Manashvi1205/warehouse-rover/code/src/src/bot_scanning/bot_scanning/callibration_images/img14.jpg

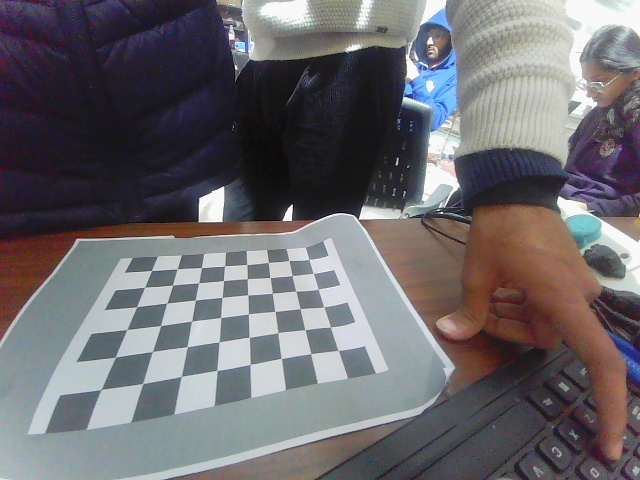
code/src/src/bot_scanning/bot_scanning/callibration_images/img14.jpg
