Manashvi1205/warehouse-rover/docs/assets/hero-qr-scan.jpg

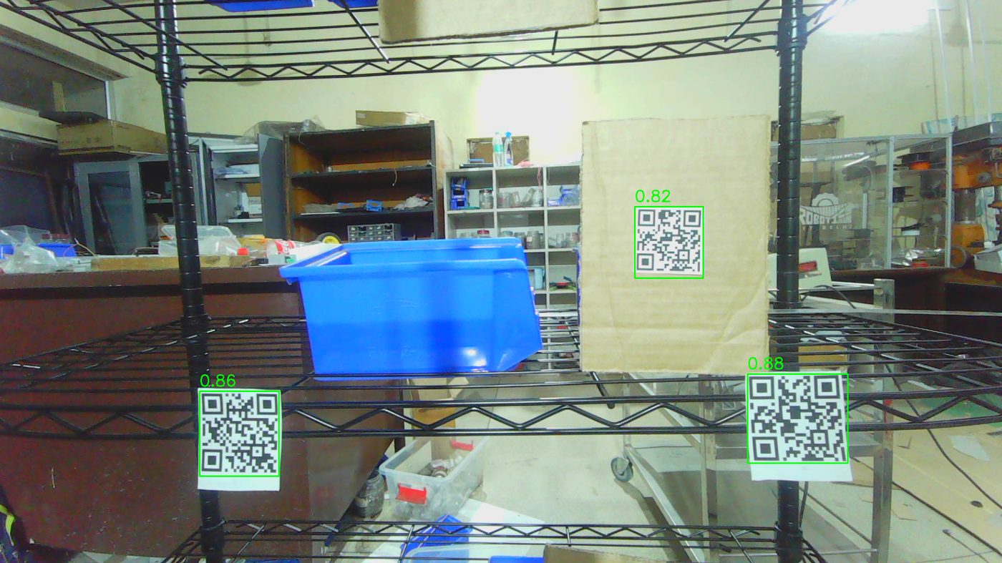
docs/assets/hero-qr-scan.jpg
