Manashvi1205/warehouse-rover/docs/assets/qr-sample.png

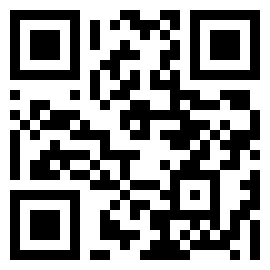
docs/assets/qr-sample.png
