Manashvi1205/warehouse-rover/vision/website/captures/2025-12-03_06-24-13.png

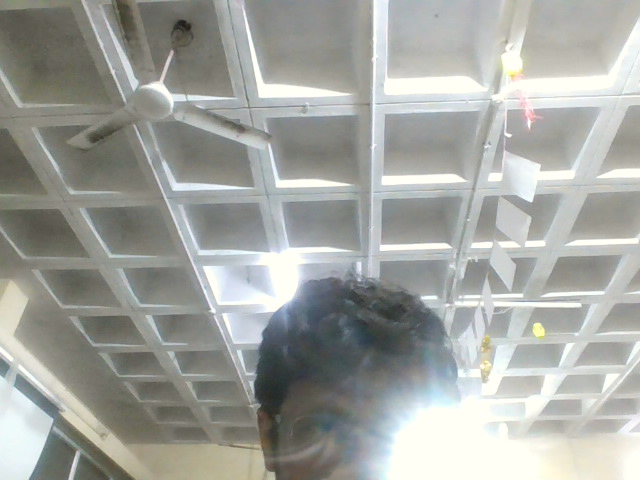
vision/website/captures/2025-12-03_06-24-13.png
