Manashvi1205/warehouse-rover/vision/website/captures/burst_2025-12-03_06-02-02.png

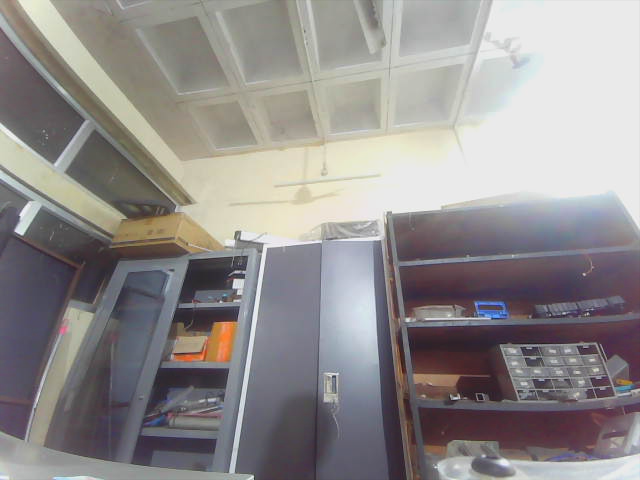
vision/website/captures/burst_2025-12-03_06-02-02.png
