Manashvi1205/warehouse-rover/vision/website/captures/burst_2025-12-03_06-06-05.png

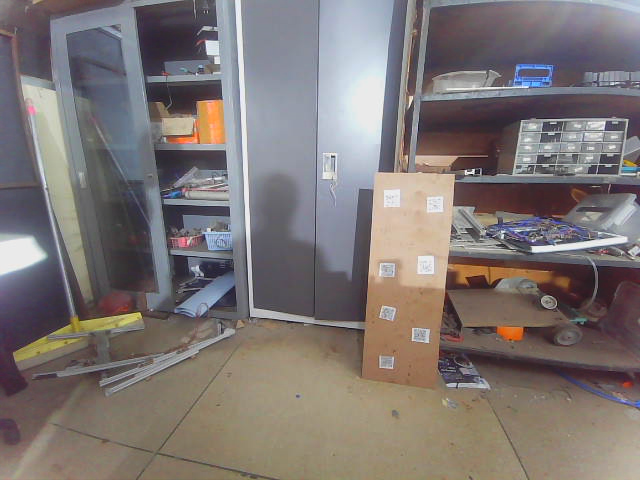
vision/website/captures/burst_2025-12-03_06-06-05.png
