Manashvi1205/warehouse-rover/vision/website/captures/capture_2025-12-03_06-26-14.png

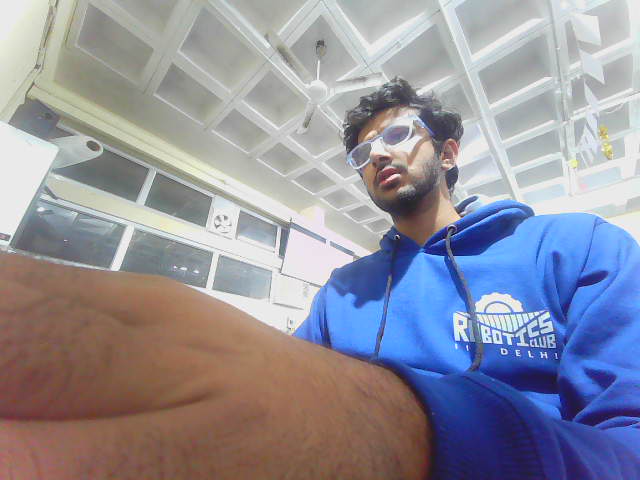
vision/website/captures/capture_2025-12-03_06-26-14.png
