Manashvi1205/warehouse-rover/vision/website/captures/capture_2025-12-03_06-27-51.png

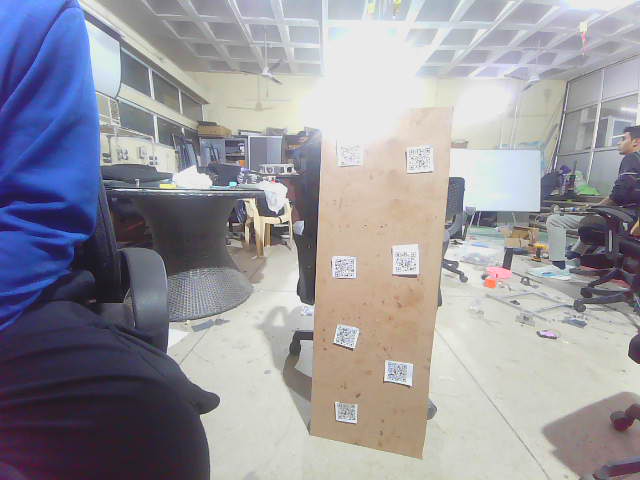
vision/website/captures/capture_2025-12-03_06-27-51.png
