Manashvi1205/warehouse-rover/vision/website/QR_R01_S1_ITM000.png

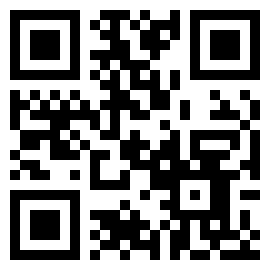
vision/website/QR_R01_S1_ITM000.png
