Manashvi1205/warehouse-rover/vision/website/QR_R01_S2_ITM345.png

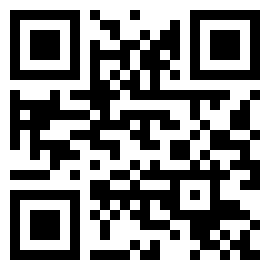
vision/website/QR_R01_S2_ITM345.png
