Manashvi1205/warehouse-rover/vision/website/QR_R01_S3_ITM347.png

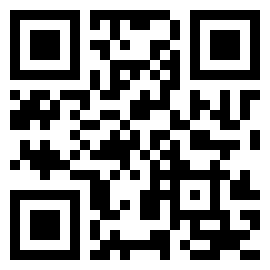
vision/website/QR_R01_S3_ITM347.png
