Manashvi1205/warehouse-rover/vision/website/QR_R01_S4_ITM555.png

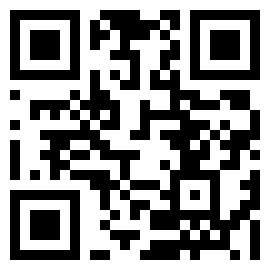
vision/website/QR_R01_S4_ITM555.png
