Manashvi1205/warehouse-rover/vision/website/QR_R01_S4_ITM996.png

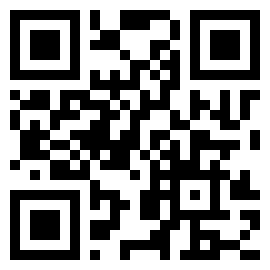
vision/website/QR_R01_S4_ITM996.png
