Manashvi1205/warehouse-rover/vision/website/QR_R01_S5_ITM031.png

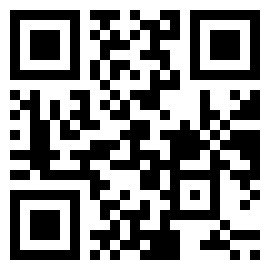
vision/website/QR_R01_S5_ITM031.png
