Manashvi1205/warehouse-rover/vision/website/QR_R02_S1_ITM001.png

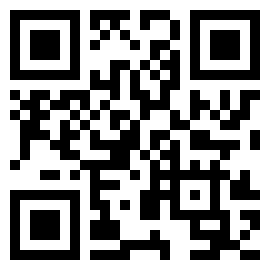
vision/website/QR_R02_S1_ITM001.png
