Manashvi1205/warehouse-rover/vision/website/QR_R02_S2_ITM121.png

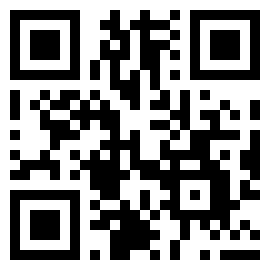
vision/website/QR_R02_S2_ITM121.png
