Manashvi1205/warehouse-rover/vision/website/QR_R02_S3_ITM008.png

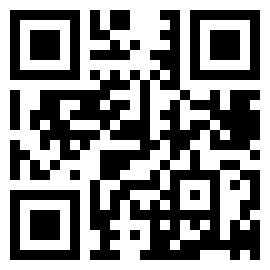
vision/website/QR_R02_S3_ITM008.png
