Manashvi1205/warehouse-rover/vision/website/QR_R02_S4_ITM299.png

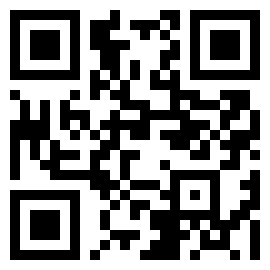
vision/website/QR_R02_S4_ITM299.png
