Manashvi1205/warehouse-rover/vision/website/QR_R02_S7_ITM067.png

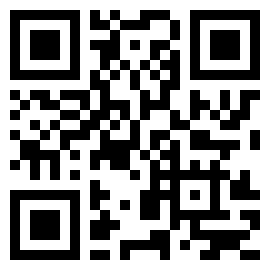
vision/website/QR_R02_S7_ITM067.png
