Manashvi1205/warehouse-rover/vision/website/QR_R03_S2_ITM451.png

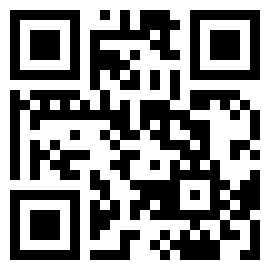
vision/website/QR_R03_S2_ITM451.png
