Manashvi1205/warehouse-rover/vision/website/QR_R04_S5_ITM012.png

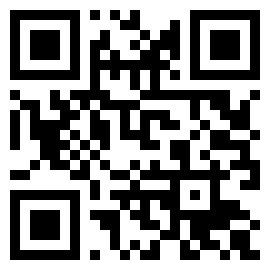
vision/website/QR_R04_S5_ITM012.png
