Manashvi1205/warehouse-rover/code/src/src/bot_description/urdf/meshes/base_link.stl

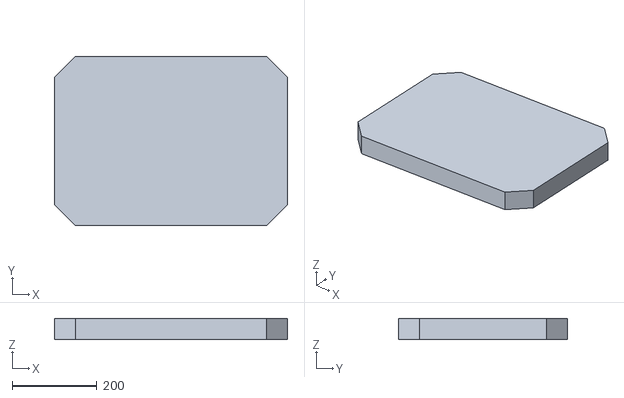
[picture p67: CAD file, 2026-11-06]
code/src/src/bot_description/urdf/meshes/base_link.stl
550.0 x 400.0 x 50.0
