Manashvi1205/warehouse-rover/code/src/src/bot_description/urdf/meshes/upper_box.stl

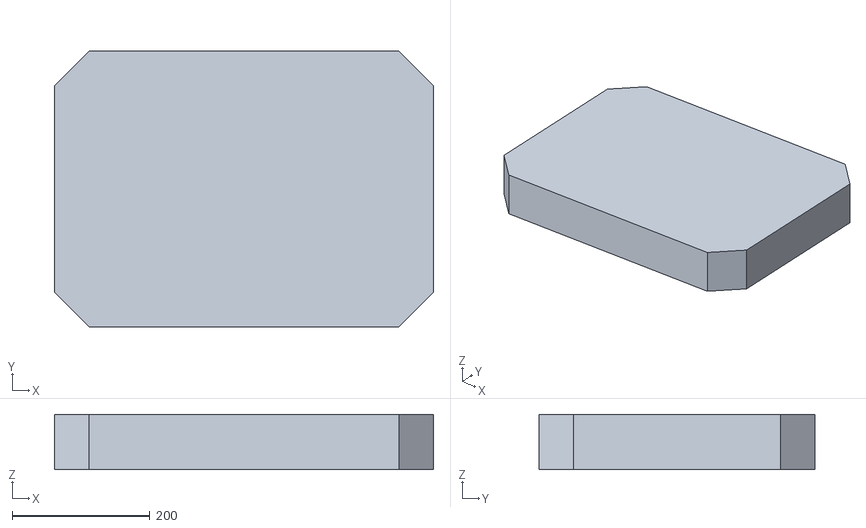
[picture p68: CAD file, 2026-11-06]
code/src/src/bot_description/urdf/meshes/upper_box.stl
550.0 x 400.0 x 80.0
