Manashvi1205/warehouse-rover/code/src/src/bot_description/urdf/meshes/pillars.stl

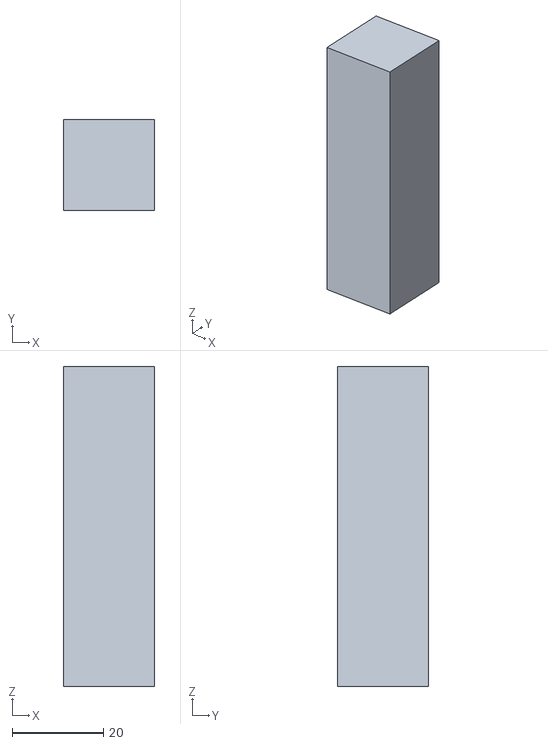
[picture p69: CAD file, 2026-11-06]
code/src/src/bot_description/urdf/meshes/pillars.stl
20.0 x 20.0 x 70.0
