Manashvi1205/warehouse-rover/code/src/src/bot_description/urdf/meshes/sphere.stl

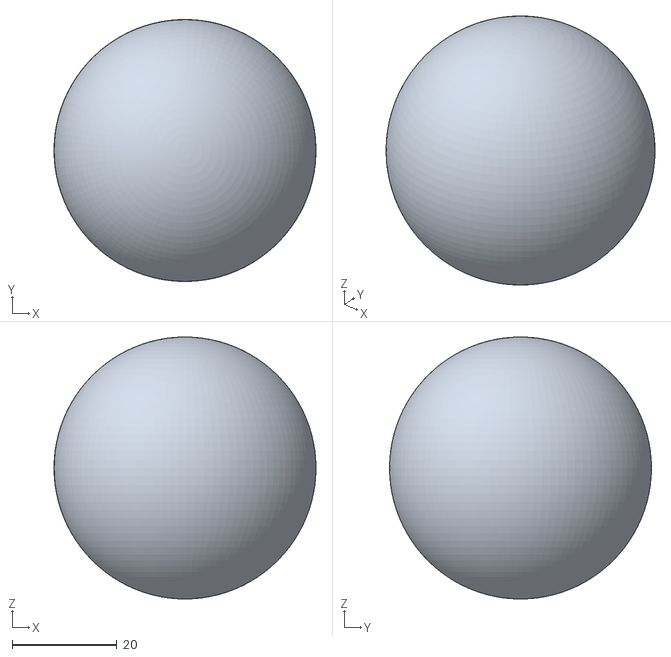
[picture p70: CAD file, 2026-11-06]
code/src/src/bot_description/urdf/meshes/sphere.stl
50.0 x 50.0 x 50.0
