Manashvi1205/warehouse-rover/code/src/src/bot_description/urdf/meshes/wheel.stl

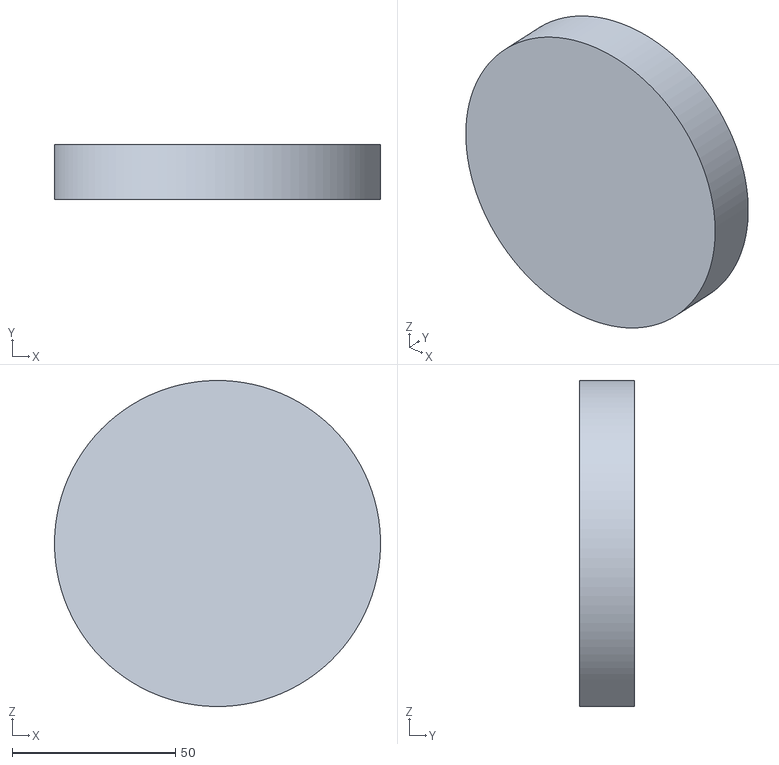
[picture p71: CAD file, 2026-11-06]
code/src/src/bot_description/urdf/meshes/wheel.stl
100.0 x 17.0 x 100.0
