Manashvi1205/warehouse-rover/(list of files, cad)

Other CAD files:
code/src/src/bot_description/worlds/meshes/full_arena.stl
hardware/CAD_Models/CAD and Drawings/Bot.step
