Manashvi1205/warehouse-rover/code/src/src/bot_description/urdf/mobile_robot.xacro

<?xml version="1.0"?>
<robot xmlns:xacro="http://www.ros.org/wiki/xacro">
  <xacro:property name="base_length" value="0.55" />
  <xacro:property name="base_width" value="0.4" />
  <xacro:property name="base_height" value="0.06" />
  <xacro:property name="wheel_radius" value="0.05" />
  <xacro:property name="wheel_length" value="0.02" />
  <xacro:macro name="wheel_link" params="prefix">
    <link name="${prefix}_wheel_link">
       <visual>
        <geometry>
          <cylinder radius="${wheel_radius}" length="${wheel_length}" />
        </geometry>
        <origin xyz="0 0 0" rpy="${pi / 2.0} 0 0" /><material name="gray" />
      </visual>
      <collision>
        <geometry>
          <sphere radius="${wheel_radius}"/>
        </geometry>
        <origin xyz="0 0 0" rpy="0 0 0" /><material name="gray" />
      </collision>
      <xacro:cylinder_inertia m="1.0" r="${wheel_radius}" l="${wheel_length}" o_xyz="0 0 0" o_rpy="${pi / 2.0} 0 0" />
    </link>
  </xacro:macro>
  <link name="base_link">
    <visual>
      <geometry>
        <box size="${base_length} ${base_width} ${base_height}" />
      </geometry>
      <origin xyz="0 0 ${base_height / 2.0}" rpy="0 0 0" />
      <material name="green" />
    </visual>
    <collision>
      <geometry>
        <box size="${base_length} ${base_width} ${base_height}" />
      </geometry>
      <origin xyz="0 0 ${base_height / 2.0}" rpy="0 0 0" />
    </collision>
    <xacro:box_inertia m="5.0" x="${base_length}" y="${base_width}" z="${base_height}" o_xyz="0 0 ${base_height / 2.0}" o_rpy="0 0 0" /> 
  </link>
  <xacro:wheel_link prefix="right" />
  <!-- <link name="right_wheel_link">
    <visual>
      <geometry>
        <cylinder radius="${wheel_radius}" length="${wheel_length}" />
      </geometry>
      <origin xyz="0 0 0" rpy="${pi / 2.0} 0 0" />
      <material name="gray" />
    </visual>
  </link> -->
  <joint name="base_right_wheel_joint" type="continuous">
    <parent link="base_link" />
    <child link="right_wheel_link" />
    <origin xyz="0 ${-(base_width + wheel_length) / 2.0} 0" rpy="0 0 0" />
    <axis xyz="0 1 0" rpy="0 0 0"/>
  </joint>
  <xacro:wheel_link prefix="left" />
  <!-- <link name="left_wheel_link">
    <visual>
      <geometry>
        <cylinder radius="${wheel_radius}" length="${wheel_length}" />
      </geometry>
      <origin xyz="0 0 0" rpy="${pi / 2.0} 0 0" />
      <material name="gray" />
    </visual>
  </link> -->
  <joint name="base_left_wheel_joint" type="continuous">
    <parent link="base_link" />
    <child link="left_wheel_link" />
    <origin xyz="0 ${(base_width + wheel_length) / 2.0} 0.0" rpy="0 0 0" />
    <axis xyz="0 -1 0" rpy="0 0 0"/>
  </joint>
  <link name="caster_wheel_link_front">
    <visual>
      <geometry>
        <sphere radius="${wheel_radius / 2.0}" />
      </geometry>
      <origin xyz="0 0 0" rpy="0 0 0" />
      <material name="gray" />
    </visual>
    <collision>
      <geometry>
        <sphere radius="${wheel_radius / 2.0}" />
      </geometry>
      <origin xyz="0 0 0" rpy="0 0 0" />
    </collision>
    <xacro:sphere_inertia m="0.5" r="${wheel_radius / 2.0}" o_xyz="0 0 0" o_rpy="0 0 0" />
  </link>
  <joint name="base_caster_wheel_joint" type="fixed">
    <parent link="base_link" />
    <child link="caster_wheel_link_front" />
    <origin xyz="${base_length / 3.0} 0 ${-wheel_radius / 2.0}" rpy="0 0 0" />
  </joint>

  <link name="caster_wheel_link_back">
    <visual>
      <geometry>
        <sphere radius="${wheel_radius / 2.0}" />
      </geometry>
      <origin xyz="0 0 0" rpy="0 0 0" />
      <material name="gray" />
    </visual>
    <collision>
      <geometry>
        <sphere radius="${wheel_radius / 2.0}" />
      </geometry>
      <origin xyz="0 0 0" rpy="0 0 0" />
    </collision>
    <xacro:sphere_inertia m="0.5" r="${wheel_radius / 2.0}" o_xyz="0 0 0" o_rpy="0 0 0" />
  </link>
  <joint name="base_caster_wheel_joint2" type="fixed">
    <parent link="base_link" />
    <child link="caster_wheel_link_back" />
    <origin xyz="${-base_length / 3.0} 0 ${-wheel_radius / 2.0}" rpy="0 0 0" />
  </joint>

  <link name="base_footprint">
    <!-- <inertial>
      <mass value="0.0001"/> 
      <origin xyz="0 0 0" rpy="0 0 0"/>
      <inertia ixx="1e-6" ixy="0" ixz="0" iyy="1e-6" iyz="0" izz="1e-6"/>
    </inertial> -->
  </link>

  <joint name="base_joint" type="fixed">
    <parent link="base_link" />
    <child link="base_footprint" />
    <origin xyz="0 0 0" rpy="0 0 0" />
  </joint>

  
  
</robot>
