Manashvi1205/warehouse-rover/hardware/CAD_Models/CAD and Drawings/Cam Assembly Drawing.pdf

50 10 R1

38.2 Ø4.5 Ø24Ø20 | M5X10 Bolt | M3 Nut

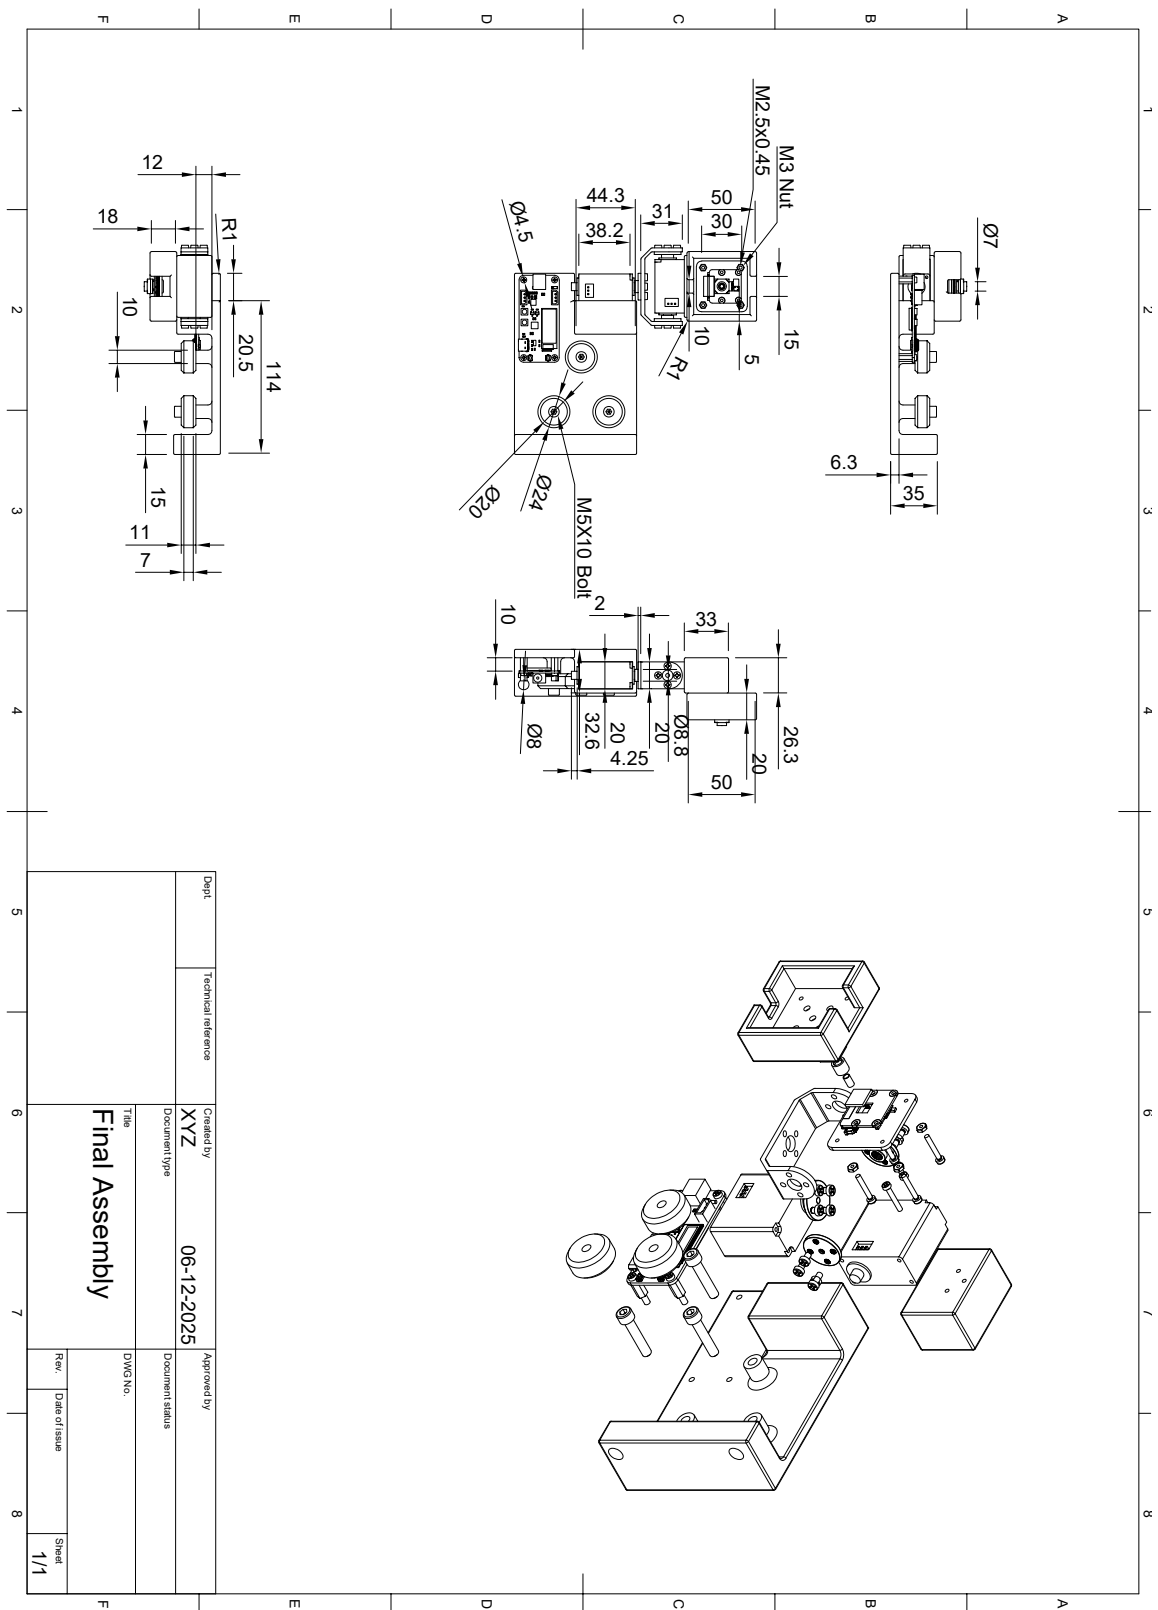
[picture p72: page 1]

1 A 2 3 4 5 6 7 8 1 2 3 4 5 6 7 8 FEDCB FEDCBA Dept. Technical reference Created by Approved by Title DWG No. Document type Document status Rev. Date of issue Sheet 06-12-2025 1/1 Final Assembly XYZ
